vneshikj/Inductive-Drive-RC-Car/Implementation/Deliverables/EE734_IPT_Equation_Template_24_ldig874_vnes637.docx

IPT Pick-up Design Equations

Eq. # | Equation
(1) | Io (for R_L <11.66Ω ) is the largest current possible: I_(out) =1.1I_(sc) ≈1.29
(2) | Io (for R_L ≥11.66Ω ): I_(out) =(V_(out(nominal)))/(R_(Load))
(3) | Vout: V_(out) =I_(out) R_(Load)
(4) | Pout: P_(out) =(V_(out)^2)/(R_(Load))=I_(out)^2 R_(Load) =V_(out) I_(out)
(5) | Duty Cycle (D): P_(out) =P_(max) (1-D) D=1-(P_(out))/(P_(max)) Where Pmax is given by: P_(max) =(1.1I_(sc) ×V_(out(nominal)) )
(6) | Qmax: Q_(max) =(1.1 V_(out))/(V_(oc))
(7) | Qavg: Q_(avg) =(P_(out))/(S_u)=(V_(out) I_(out))/(V_(oc) I_(sc))
(8) | C2 Compensation Capacitor: Impedance matching to increase overall power: jωL_2 =-1/(jωC_2) Rearranging and solving, we are able to find C2: C_2 =|1/((jω)^2 L_2)
(9) | Max V2: We know that VC2 is the voltage before the rectifier stage and due to parallel compensation: V_(out, nominal) =(V_2)/1.1 Rearranging and solving we are able to find V2: V_2 =1.1⋅V_(out,nominal)
(10) | Max IC2: I_(c_2 ,max) =(V_2)/(Z_(C_2))=|j2πf_0 ⋅C_2 ⋅V_2
(11) | Cmin can be found with the following formula: C_(min) =C_(dc) >(πI_(sc))/(8√2f_(s,max) ΔV_(out))
(12) | fs (for R ≥ 11.66Ω ): f_s ≈(πI_(sc))/(8√2 C_(dc) ΔV_(out)) fs (for R < 11.66Ω, i.e. not sufficient to begin switching ): f_s =0
(13) | IC,rms: Given the two states of IC,rms when the switch is on and off: I_(C,RMS) =√(1/(T_s)∫_0^(DT_s) -I_(out)^2 dt+∫_(DT_s)^(T_s) (I_(dc) -I_(out) )^2)
(14) | Capacitor power loss ( P_(loss,C_(dc)) ): P_(loss,C_(dc)) =I_(rms,C_(dc))^2 ⋅R_(esr,C_(dc))
(15) | Evaluating feedback resistor network: 1. ΔV_(out) =V_(op) (R_a)/(R_f) 2. V_(out,avg) =V_(ref) (R_a R_b +R_f (R_a +R_b ))/(R_f R_b)-V_(op) (R_a)/(2R_f) Rearranging both equations for Rf and equating we get the following equation: V_(op) (R_a)/(ΔV_(out))=(-V_(op) R_a R_b +2V_(ref) R_a R_b)/(2V_(out,avg) R_b +2V_(ref) R_a ++2V_(ref) R_b) Subbing in chosen R_b =10kΩ and solving for Ra.
(16) | Rf can be found by using ‘1.’ from above solution: R_f =V_(op) (R_a)/(ΔV_(out))
(17) | N: L=A_L ⋅N_i^2 N=√(L/(A_L))
(18) | Bc(max): B_(c[max]) =(LI_(L,avg))/(NA_e)
(19) | Single strand copper cross sectional area (Acu): A_(cu) =(π d_(cu)^2)/4
(20) | Used winding area: K_f =(NA_(cu))/(A_N) ≤ 1 A_N =(NA_(cu))/(K_f)
(21) | Jmax: J_(max) =(I_(RMS(max)))/(A_(cu))
(22) | Bundle Rw (dc): R_(ω(dc)) =(ρNl_n)/(A_(cu))
(23) | Steady-state wire losses (Pcu): P_(cu) =R_(ω(dc)) ⋅I_(L,RMS)^2
(24) | Gate driver resistance (Rg): R_g =(V_(gg))/(I_(gg))
(25) | Is @ on: I_(s,on) =I_(L,avg) -(ΔI_L)/2 Is @ off: I_(s,on) =I_(L,avg) +(ΔI_L)/2 Where ΔI_L is given by: ΔI_L =(8 ΔV_(out) Cdc)/(T_s)
(26) | tvf: t_(vf) =(V_(sw) -R_(ds,ON) ⋅I_(s,ON) )(R_g C_(rss,V_(sw) /2))/(V_(gg) -V_(gs(io)))
(27) | tvr: t_(vr) =(V_(sw) -R_(ds,ON) ⋅I_(s,OFF) )(R_g C_(rss,V_(sw) /2))/(V_(gs(io)))
(28) | ts,on: t_(s,on) =t_(ir) +t_(vf) Where t_(ir) = current rise time and t_(vf) = voltage fall time.
(29) | ts,off: t_(s,off) =t_(if) +t_(vr) Where t_(if) = current fall time and t_(vr) = voltage rise time.
(30) | Pswitching: P_(switching) =(V_(s,off) f_s)/2[I_(s,on) t_(s,on) +I_(s,off) t_(s,off) ]
(31) | Pconduction: P_(conduction) =1/(T_s)∫_0^(T_(s,on)) V_s I_s dt=I_(s,RMS)^2 ⋅R_(ds,on)
(32) | Ptotal: P_(total) =P_(switching) +P_(conduction)
(33) | Tj,max: T_j =T_a +P_T R_(θja)
(34) | ID,avg: I_(D,avg) =(1-D)I_(D,avg[MAX])
(35) | Pconduction loss: P_(conduction) =(1-D)V_F I_(L,avg)
(36) | Reverse recovery loss (Prr): P_(rr) ≈V_R Q_(rr) f_s Where Q_(rr) =I_(rr) (t_(rr))/2 However, due to the Schottky diode’s physical make-up: P_(rr(schottky)) =0W
(37) | Ptotal: P_(total) =P_(conduction) +P_(rr)
(38) | Tj,max: Similar to (33): T_j =T_a +P_T R_(θja)
