vneshikj/Inductive-Drive-RC-Car/Implementation/Deliverables/EE734_IPT_Design_Report_24_ldig874_vnes637.xlsx

Sheet: Operating Conditions
Pick-up Converter Design - Part I
Specifications
Parameter | Value | Unit
Nominal Vout(avg) | 15.00 | V
Isc(rms) | 1.17 | A
Voc(rms) | 7.12 | V
Winding L2 | 25.00 | µH
Track f0 | 38.40 | kHz
Evaluating Steady-State Operating Conditions
Parameter | Value | Unit (eq) | Value | Unit (eq) | Value | Unit (eq)
Load | 10.00 | Ω | 15.00 | Ω | 25.00 | Ω
Io | 1.29 | A (1) | 1.00 | A (2) | 0.60 | A (2)
Vout | 12.87 | V (3) | 15.00 | V (3) | 15.00 | V (3)
Po | 16.56 | W (4) | 15.00 | W (4) | 9.00 | W (4)
D | 0.00 | % (5) | 22.30 | % (5) | 53.38 | % (5)
Qmax | 1.99 | (6) | 2.32 | (6) | 2.32 | (6)
Qavg | 1.99 | (7) | 1.80 | (7) | 1.08 | (7)
Evaluating Compensation Capacitor
Parameter | Value | Unit (eq)
C2 | 0.67 | µF (8)
Max V2 | 16.50 | V (9)
Max IC2 | 2.67 | A (10)

Sheet: Capacitor & Controller
Pick-up Converter Design - Part II
Specifications
Parameter | Value | Unit
Max fs | 1000.00 | Hz
Nominal Vout | 15.00 | V
Max Iout | 1.29 | A
Design ΔVo | 1.00 | V,peak to peak
Minimum Capacitance to Meet ΔVo
Parameter | Value | Unit (eq)
C(min) | 324.89 | µF (11)
Selecting a Capacitor
Parameter | Value | Unit
Manufacturer | Panasonic
Series | TP
Voltage rating | 25 | V
Capacitance | 470 | µF
ESR | 130 | mΩ
IC,rms rating | 1.1 | A
Evaluating Steady-State Capacitor Losses
Parameter | Value | Unit (eq) | Value | Unit (eq) | Value | Unit (eq)
Load | 10.0 | Ω | 15.0 | Ω | 25.0 | Ω
fs | 0.0 | Hz (12) | 479.1 | Hz (12) | 688.1 | Hz (12)
IC,rms | 0.0 | A (13) | 0.5 | A (13) | 0.6 | A (13)
PC | 0.0 | mW (14) | 37.3 | mW (14) | 53.8 | mW (14)
Evaluating Feedback Resistor Network
Parameter | Value | Unit
Vref | 4.00 | V | E12 Series Values used in slides
Vo,opamp | 15.00 | V
Selected Rb | 10.00 | kΩ
Ra | 14.33 | kΩ (15)
Rf | 214.95 | kΩ (16)

Sheet: Inductor
Pick-up Converter Design - Part III
Specifications
Parameter | Value | Unit
Max IL(Avg) | 1.29 | A
Ripple fs | 38.40 | kHz
Design Bmax | 0.25 | T
Design Jmax | 5.00 | A/mm^2
Core & Magnet Wire Details
Parameter | Value | Unit
Core type | Drum15
Al | 0.052 | µH
Ae | 28.30 | mm^2
AN | 36.00 | mm^2
ln | 31.50 | mm
Wire ρ | 1.8e-08 | Ωm
Wire µ0 | 1.256637061e-06 | H/m
Achievable Kf | 0.70
Design Choices
Parameter | Value | Unit (eq)
Selected L | 200.00 | µH
Selected dcu | 0.56 | mm
Evaluating Inductor Parameters
Parameter | Value | Unit (eq)
N | 63 | Turns (17)
Bc(max) | 0.14 | T (18)
Acu (1 strand) | 0.2463 | mm^2 (19)
Used Winding Area | 22.17 | mm^2 (20)
Jmax | 5.24 | A/mm^2 (21)
Bundle Rw(dc) | 145.0 | mΩ (22)
Evaluating Steady-State Inductor Losses
Parameter | Value | Unit (eq) | Value | Unit (eq) | Value | Unit (eq)
Load | 10.0 | Ω | 15.0 | Ω | 25.0 | Ω
IL,rms | 1.3 | A | 1.3 | A | 1.3 | A
Pcu | 241.34 | mW (23) | 241.34 | mW (23) | 241.34 | mW (23)

Sheet: Switch
Pick-up Conveter Design - Part IV
Specifications
Parameter | Value | Unit
Max Vsw | 15.00 | V
Max Is,rms | 1.29 | A
Ta | 30.00 | Degrees C
Selecting a N-Channel MOSFET
Parameter | Value | Unit
Manufacturer | infineon
Model no | IPP052N06L3
Vdss | 60 | V
ID(max) | 80 | A
tr | 5 | ns
tf | 12 | ns
Crss @ Max Vsw/2 | 47 | pF
Vgs(Io) | 4.5 | V
Rds,on | 5 | mΩ
RthJA - no heatsink | 62 | C/W
Gate Drive Details
Parameter | Value | Unit (eq)
Design Vgg | 15.00 | V
Design Igg | 0.10 | A
Rg | 150.00 | Ω (24)
Evaluating Steady-State Switch Losses
Parameter | Value | Unit (eq) | Value | Unit (eq) | Value | Unit (eq)
Load | 10.00 | Ω | 15.0 | Ω | 25.0 | Ω
fs | 0.00 | Hz | 479.09 | Hz | 688.09 | Hz
Is,rms | 0.00 | A | 0.61 | A | 0.94 | A
Is @ on | 0.00 | A (25) | 0.66 | A (25) | 0.39 | A (25)
Is @ off | 0.00 | A (25) | 1.91 | A (25) | 2.18 | A (25)
tfv | 10.07 | ns (26) | 10.07 | ns (26) | 10.07 | ns (26)
trv | 23.49 | ns (27) | 23.49 | ns (27) | 23.49 | ns (27)
ts,on | 15.07 | ns (28) | 15.07 | ns (28) | 15.07 | ns (28)
ts,off | 35.49 | ns (29) | 35.49 | ns (29) | 35.49 | ns (29)
Pswitching | 0.00 | mW (30) | 0.28 | mW (30) | 0.43 | mW (30)
Pconduction | 0.00 | mw (31) | 1.85 | mw (31) | 4.42 | mw (31)
Ptotal | 0.00 | mw (32) | 2.13 | mw (32) | 4.85 | mw (32)
Evaluating Junction Temperature
Parameter | Value | Unit (eq)
Tj,max | 30.30 | C (33)

Sheet: Diode
Pick-up Converter Design - Part V
Specifications
Parameter | Value | Unit (eq)
Max Vd | 15.00 | V
Max Id,avg | 1.29 | A
Ta | 30.00 | Degrees C
Selecting a Diode
Parameter | Value | Unit
Manufacturer | Vishay
Model no | VS-MBR1045-M3
Vr(max) | 45 | V
IF(max) - dual | 10 | A
VF | 0.57 | V
RthJA - D2Pak | n/a | C/W
Evaluating Steady-State Switch Losses
Parameter | Value | Unit (eq) | Value | Unit (eq) | Value | Unit (eq)
Load | 10.00 | Ω | 15.0 | Ω | 25.0 | Ω
D | 0.00 | % | 22.30 | % | 53.38 | %
ID,avg | 1.29 | A (34) | 1.00 | A (34) | 0.60 | A (34)
Pconduction | 0.73 | W (35) | 0.57 | W (35) | 0.34 | W (35)
Prr | 0.00 | W (36) | 0.00 | W (36) | 0.00 | W (36)
Ptotal | 0.73 | W (37) | 0.57 | W (37) | 0.34 | W (37)
Evaluating Junction Temperature
Parameter | Value | Unit (eq)
Tj,max | 75.00 | C (38) | Approximation assuming similar RthJA to MOSFET
