vneshikj/Inductive-Drive-RC-Car/Implementation/Buck/EE734_Buck_Design_Template_24_UPI.xlsx

Sheet: Operating Conditions
Buck Conveter Design - Part I
Specifications
Parameter | Value | Unit
Nominal Vin(avg) | 15.00 | V
Max Iin(avg) | 1.30 | A
Max Vout(avg) | 9.70 | V
Max RL(max) | 10.00 | Ω
Min RL(min) | 2.00 | Ω
Design η | 90.00 | %
Operating fs | 100.00 | kHz
Evaluating Steady-State Operating Conditions
Parameter | Value | Unit (eq) | Value | Unit (eq) | Value | Unit (eq)
Load RL | 2.00 | Ω | 4.00 | Ω | 10.00 | Ω
Pout | 17.55 | W (1) | 17.55 | W (1) | 9.41 | W (2)
Io=IL(avg) | 2.96 | A (3) | 2.10 | A (3) | 1.32 | A (3)
Iin(avg)=Is(avg) | 1.30 | A (4) | 1.30 | A (4) | 0.70 | A (4)
D | 43.88 | % (5) | 62.07 | % (5) | 71.85 | % (5)
Vout | 5.92 | V (6) | 8.38 | V (6) | 9.70 | V (6)
Evaluating Minimum Inductance
Parameter | Value | Unit (eq)
Vin(critical) | 15.00 | V
RL(critical) | 10.00 | Ω
D @ RL(critical) | 71.85 | %
Lmin | 10.27 | µH (7)
Selected Inductance
Parameter | Value | Unit (eq)
L(selected) | 25.00 | µH
Evaluating Steady-State Ripple and RMS Curents
Parameter | Value | Unit (eq) | Value | Unit (eq) | Value | Unit (eq)
Load RL | 2.00 | Ω | 4.00 | Ω | 10.00 | Ω
ΔIL | 1.33 | A (8) | 1.27 | A (8) | 1.09 | A (8)
IL,pk | 3.63 | A (9) | 2.74 | A (9) | 1.88 | A (9)
IL,rms | 2.98 | A (10) | 2.13 | A (10) | 1.37 | A (10)
Iin,rms=Is,rms | 1.98 | A (11) | 1.68 | A (11) | 1.16 | A (11)
IC,rms | 0.38 | A (12) | 0.37 | A (12) | 0.31 | A (12)

Sheet: Inductor
Buck Conveter Design - Part II
Specifications
Parameter | Value | Unit
Selected L | 25.00 | µH
Max IL,pk | 3.63 | A
Max IL,rms | 2.98 | A
Operating fs | 100.00 | kHz
Design Bmax | 0.25 | T
Design Jmax | 5.00 | A/mm^2
Core, Former & Magnet Wire Details
Parameter | Value | Unit
Core type | EFD20
Core material | N87
Ae | 31.00 | mm^2
le | 47.00 | mm
Ve | 1460.00 | mm^3
AN | 28.10 | mm^2
ln | 40.20 | mm
Wire ρ | 1.8e-08 | Ωm
Wire µ0 | 1.256637061e-06 | H/m
Achievable Kf | 0.65
Design Choices
Parameter | Value | Unit (eq)
Selected Air-gap (lg) | 0.15 | mm
Wire dcu | 0.43 | mm (13)
Evaluating Inductor Parameters
Parameter | Value | Unit (eq)
N | 14 (13.64) | Turns (14)
Bc(max) | 0.22 | T (15)
Acu per strand | 1.45e-07 | m^2 (16)
Np | 9 | Strands (17)
Acu per bundle | 1.31e-06 | m^2 (18)
Jmax | 2.27 | A/mm^2 (19)
Bundle Rw(dc) | 7.7 | mΩ (20)
Evaluating Steady-State Inductor Losses
Parameter | Value | Unit (eq) | Value | Unit (eq) | Value | Unit (eq)
Load RL | 2.0 | Ω | 4.0 | Ω | 10.0 | Ω
IL,rms | 2.98 | A | 2.13 | A | 1.37 | A
ΔIL | 1.33 | A | 1.27 | A | 1.09 | A
Bac | 40.30 | mT (21) | 38.48 | mT (21) | 33.03 | mT (21)
Pcu | 68.67 | mW (22) | 35.08 | mW (22) | 14.51 | mW (22)
Pv | 8.99 | mW (23) | 8.01 | mW (23) | 5.47 | mW (23)
Ptotal | 77.66 | mW (24) | 43.09 | mW (24) | 19.98 | mW (24)

Sheet: Capacitor
Buck Conveter Design - Part III
Specifications
Parameter | Value | Unit
Max Vc | 9.70 | V
Max IC,rms | 0.38 | A
Max ΔIC=ΔIL | 1.33 | A
Ripple fs | 100.00 | kHz
Design ΔVo | 1.00 | %
Minimum Capacitance to Meet ΔVo
Parameter | Value | Unit (eq)
Co(min) | 17.14 | µF (25)
ESR(max) | 72.93 | mΩ (26)
Selecting a Capacitor
Parameter | Value | Unit
Manufacturer | Panasonic
Series | TP
Voltage rating | 35 | V
Capacitance Co | 330 | µF
ESR | 52 | mΩ
IC,rms rating | 1.1 | A
Evaluating Steady-State Capacitor Losses
Parameter | Value | Unit (eq) | Value | Unit (eq) | Value | Unit (eq)
Load RL | 2.0 | Ω | 4.0 | Ω | 10.0 | Ω
IC,rms | 0.38 | A | 0.37 | A | 0.31 | A
PC | 7.5 | mW (27) | 7.1 | mW (27) | 5.0 | mW (27)

Sheet: Switch
Buck Conveter Design - Part IV
Specifications
Parameter | Value | Unit
Max Vsw | 15.00 | V
Max Is,rms | 1.98 | A
Max Isw,pk | 3.63 | A
Switching fs | 100.00 | kHz
Ta | 30.00 | Degrees C
Selecting a N-Channel MOSFET
Parameter | Value | Unit
Manufacturer | Infineon
Model no | IPP052N06L3
Vdss | 60 | V
ID(max) | 80 | A
tr | 5 | ns
tf | 12 | ns
Crss @ Max Vsw/2 | 175 | pF
Vgs(Io) | 3.6 | V
Rds,on | 3.9 | mΩ
RthJA - no heatsink | 62 | C/W
Gate Drive Details
Parameter | Value | Unit (eq)
Design Vgg | 15.00 | V
Design Igg | 1.00 | A
Rg | 15.00 | Ω (28)
Evaluating Steady-State Switch Losses
Parameter | Value | Unit (eq) | Value | Unit (eq) | Value | Unit (eq)
Load RL | 2.00 | Ω | 4.0 | Ω | 10.0 | Ω
IL,avg | 2.96 | A | 2.10 | A | 1.32 | A
Is,rms | 1.98 | A | 1.68 | A | 1.16 | A
ΔIL | 1.33 | A | 1.27 | A | 1.09 | A
Is @ on | 2.30 | A (29) | 1.47 | A (29) | 0.79 | A (29)
Is @ off | 3.63 | A (30) | 2.74 | A (30) | 1.88 | A (30)
tvf | 3.45 | ns (31) | 3.45 | ns (31) | 3.45 | ns (31)
trv | 10.93 | ns (32) | 10.93 | ns (32) | 10.93 | ns (32)
ts,on | 8.45 | ns (33) | 8.45 | ns (33) | 8.45 | ns (33)
ts,off | 22.93 | ns (34) | 22.93 | ns (34) | 22.93 | ns (34)
Pswitching | 77.00 | mW (35) | 56.44 | mW (35) | 37.34 | mW (35)
Pconduction | 15.30 | mW (36) | 11.01 | mW (36) | 5.25 | mW (36)
Ptotal | 92.30 | mw (37) | 67.45 | mw (37) | 42.59 | mw (37)
Evaluating Junction Temprature
Parameter | Value | Unit (eq)
Tj,max | 35.72 | C (38)

Sheet: Diode
Buck Conveter Design - Part V
Specifications
Parameter | Value | Unit (eq)
Max Vd | 15.00 | V
Max Id,avg | 1.66 | A
Switching fs | 100.00 | kHz
Ta | 30.00 | Degrees C
Selecting a Diode
Parameter | Value | Unit
Manufacturer | Vishay
Model no | VS-MBR1045-M3
Vr(max) | 45 | V
IF(max) - dual | 10 | A
VF | 0.57 | V
RthJA - D2Pak | 70 | C/W | Assuming same thermal resistance as the other diodes with same case
Evaluating Steady-State Switch Losses
Parameter | Value | Unit (eq) | Value | Unit (eq) | Value | Unit (eq)
Load RL | 2.00 | Ω | 4.0 | Ω | 10.0 | Ω
IL,avg | 2.96 | A | 2.10 | A | 1.32 | A
D | 43.88 | % | 62.07 | % | 71.85 | %
ID,avg | 1.66 | A (39) | 0.80 | A (39) | 0.37 | A (39)
Pconduction | 0.94 | W (40) | 0.46 | W (40) | 0.21 | W (40)
Prr | 0.00 | W (41) | 0.00 | W (41) | 0.00 | W (41)
Ptotal | 0.94 | W (42) | 0.94 | W (42) | 0.94 | W (42)
Evaluating Junction Temprature
Parameter | Value | Unit (eq)
Tj,max | 95.80 | C (43)

Sheet: Controller
Buck Converter Design - Part VI
Specifications
Parameter | Value | Unit
Vout,nominal | 9.70 | V
Max Is,pk | 3.63 | A
Co | 330.00 | µF
ESR | 52 | mΩ
Switching fs | 100.00 | kHz
Max Td | 5.00 | %
Oscilator Setup
Parameter | Value | Unit (eq)
CT | 1 | nF
RT | 18k | kΩ
Td | 320 | ns
Current Feedback Setup
Parameter | Value | Unit (eq)
Rs | 0.28 | Ω (44)
RC filter - Rrc | 100.00 | Ω
RC filter - Crc | 159.15 | pF (45)
Voltage Feedback Setup
Parameter | Value | Unit (eq)
Tp(s) Pole fo @ 2Ω | 241.14 | Hz (46)
Tp(s) Zero fz @ 2Ω | 9.27 | kHz (47)
Tp(0) @ 2Ω | 17.71 | dB (48)
Design TOL(s) fcross | 10.00 | kHz
Tm(s) | 1.00
Required TOL(0) @ 2Ω | 32.35 | dB (49)
Required Tc(0) | 14.63 | dB (50)
Compensator Rf | 22.00 | kΩ
Compensator Cf | 0.78 | nF (51)
Compensator Ri | 4.08 | kΩ (52)
Diff Amp Gain Gdiff | 0.26 | Gain (53)
Schematic of Controller
