vneshikj/Inductive-Drive-RC-Car/Implementation/Buck/EE734_Buck_Equations_Template_24_UPI.docx

Buck Converter Design Equations

Eq. # | Equation
(1) | I_(OUT(MAX)) =√((V_(IN) I_(IN) η)/(R_(LOAD))) V_(OUT) =I×R_(LOAD) P_(OUT) =(V_(OUT) ^2)/(R_(LOAD))
(2) | P_(OUT) =(V_(OUT(MAX)) ^2)/(R_(LOAD))
(3) | I_(OUT) =(V_(OUT))/(R_(LOAD))
(4) | D=(V_(OUT))/(V_(IN) ×η) R_(IN) =1/(D^2)×R_(OUT) I_(IN) =(V_(IN))/(R_(IN))
(5) | D=(V_(OUT))/(V_(IN) ×η)
(6) | V_(OUT) =I_(OUT) ×R_(OUT) ( I_(OUT) is limited by I_(OUT(MAX)) OR V_(OUT(MAX)) )
(7) | L_(min) =(V_(OUT(MAX)) (1-D)T_S)/(ΔI_L) Where: ΔI_L =2I_(L(AVG))
(8) | ΔI_L =(V_(OUT) (1-D)T_S)/L
(9) | I_(L(peak)) =1/2ΔI_L ×I_(L(AVG))
(10) | I_(L(RMS)) =√(I_(L(AVG)) +(ΔI_L^2)/12)
(11) | I_(S(RMS)) =√([D[I_(L(AVG))^2 +(ΔI_L^2)/12]])
(12) | I_(C(RMS)) =(ΔI_L)/(√((12)))
(13) | d_(cu) ≤2δ δ=√(ρ/(πμ_0 μ_r f))
(14) | N=√((2l_g L)/(A_e μ_0))
(15) | B_(C(MAX)) =(Nμ_0 I_(MAX))/(2l_g)
(16) | A_(CU(STRAND)) =π(d_(cu)^2)/4
(17) | N_(CU) =(K_f ⋅A_N)/(N⋅A_(CU))
(18) | A_(CU(BUNDLE)) =N_P ×A_(CU(STRAND))
(19) | J_(MAX) =(I_(RMS(MAX)))/(A_(CU(STRAND)) ×10^6) (In A mm^(-2) )
(20) | R_(W(BUNDLE, DC)) =(ρ⋅N⋅I_n)/(A_(CU(BUNDLE)))
(21) | B_(ac) =(B_(MAX))/(I_(L(MAX)))×(ΔI_L)/2
(22) | R_(w(DC)) =(ρNI_n)/(A_(CU(BUNDLE))) P_(CU) =R_(w(DC)) ×I_(L(RMS))^2
(23) | P_V =k⋅f^a ⋅B_(ac) ^b Where: k=1.5⋅10^(-6) a = 1.3 b = 2.5 P_(LOSS(AC)) =P_V ×V_e Results given in mW
(24) | P_(TOTAL) =P_(cu) +P_(LOSS(AC))
(25) | C_(O(MIN)) ≥(ΔI_L T_s)/(8ΔV_o)
(26) | R_(ESR(MAX)) =(ΔV_o)/(ΔI_L)
(27) | P_C =I_(C(RMS))^2 ×R_(ESR)
(28) | R_g =(V_(gg))/(I_(gg))
(29) | I_(S(ON)) =I_(L(AVG)) -(ΔI_L)/2
(30) | I_(S(OFF)) =I_(L(AVG)) +(ΔI_L)/2
(31) | t_(fv) =(V_(ds(OFF)) -R_(DS(ON)) I_(S(ON)) )×(R_g C_(rss(Vsoff/2)))/(V_(gg) -V_(gs(I_o )))
(32) | t_(rv) =(V_(ds(OFF)) -R_(DS(ON)) I_(S(OFF)) )×(R_g C_(rss(Vsoff/2)))/(V_(gs(I_o )))
(33) | T_(S(ON)) =t_r +t_(fv)
(34) | T_(S(OFF)) =t_f +t_(rv)
(35) | P_(SWITCHING) =(V_(S(OFF)) f_s)/2×[I_(S(ON)) t_(S(ON)) +I_(S(OFF)) t_(S(OFF)) ]
(36) | P_(CONDUCTION) =I_(S(RMS))^2 ×R_(DS(ON))
(37) | P_(TOTAL) =P_(CONDUCTION) +P_(SWITCHING)
(38) | T_(j(MAX)) =T_a +P_T ×R_(θja)
(39) | I_(D(AVG)) =I_(L(AVG)) (1-D)
(40) | P_(CONDUCTION) =I_(D(AVG)) ⋅V_F
(41) | P_(rr) =V_R Q_(rr) f_s
(42) | P_(TOTAL) =P_(CONDUCTION) +P_(SWITCHING)
(43) | T_(j(MAX)) =T_a +P_T ×R_(θja)
(44) | R_S =1/(I_(S(MAX)))
(45) | C_(rc) =1/(2πR_c f_(cutoff))
(46) | T_p (s)=(R_L)/(R_S)×(sC_(out) r_(esr) +1)/(sC_(out) R_L +1)
(47) | f_p =1/(2πC_o R_L)
(48) | f_z =1/(2πC_o R_c)
(49) | T_c (0)=log[(f_(cross))/(f_p)]×20 –T_p (0) T_p (0)=(R_L)/(R_s) T_(OL) (0)=T_p (0)⋅T_c (0)⋅T_m (0)
(50) | T_c (0)=log[(f_(cross))/(f_p)]×20 –T_p (0)
(51) | C_f =1/(2πf_p R_f) Where: f_p is set to cancel plant zero
(52) | R_i =(R_f)/(10^((T_c (0))/20)) Where: T_c (0) is gain in dB
(53) | G_(DIFF) =2.5/(V_(OUT(NOMINAL)))
