vneshikj/Inductive-Drive-RC-Car/Labs/Lab 1/Lab workings.docx

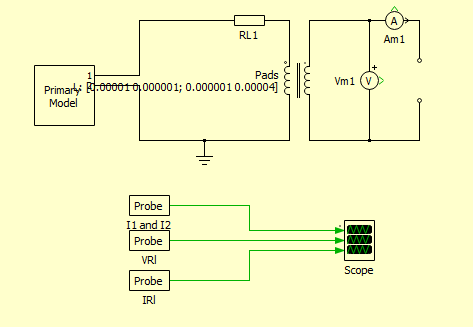
[picture p2: figure]
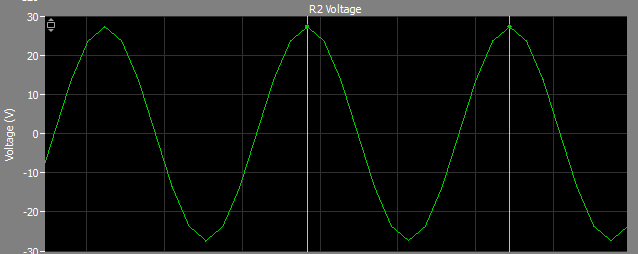
[picture p3: figure]
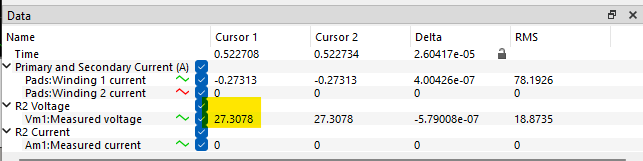
[picture p4: figure]
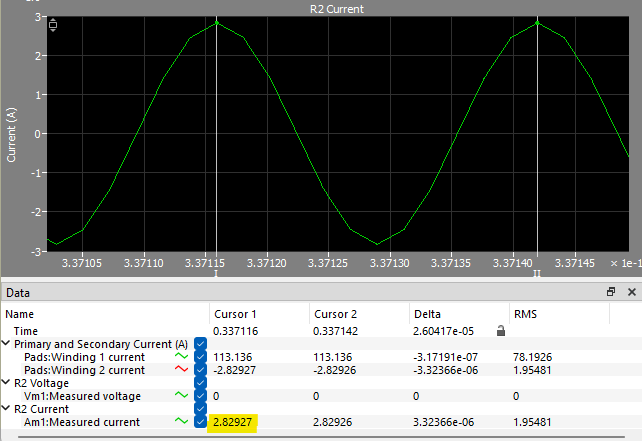
[picture p5: figure]

Task 2

Used the following values

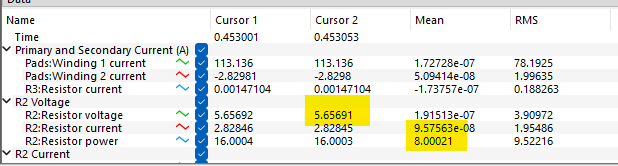
[picture p6: figure]

2ohms

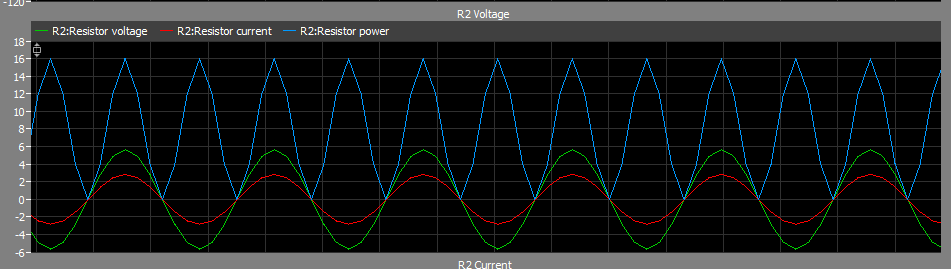
[picture p7: figure]

4ohms

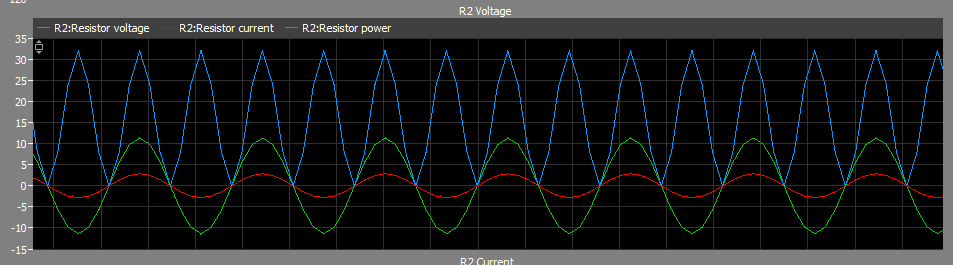
[picture p8: figure]

8ohms

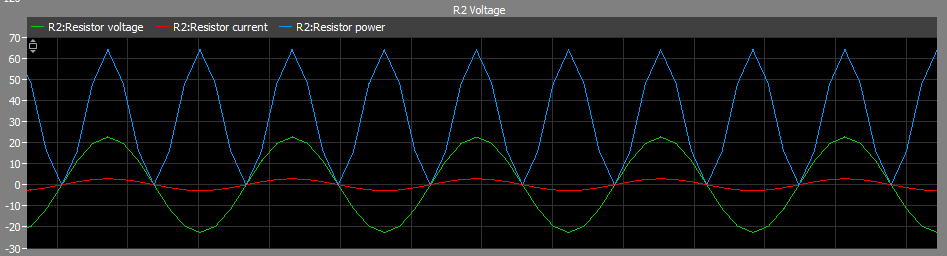
[picture p9: figure]

12ohms

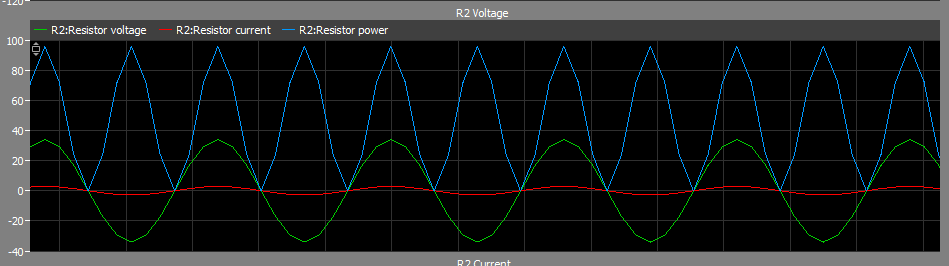
[picture p10: figure]

16ohms

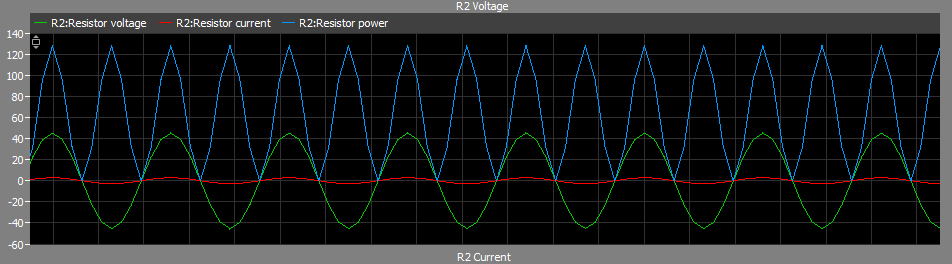
[picture p11: figure]

Task 3

b)

R = 2

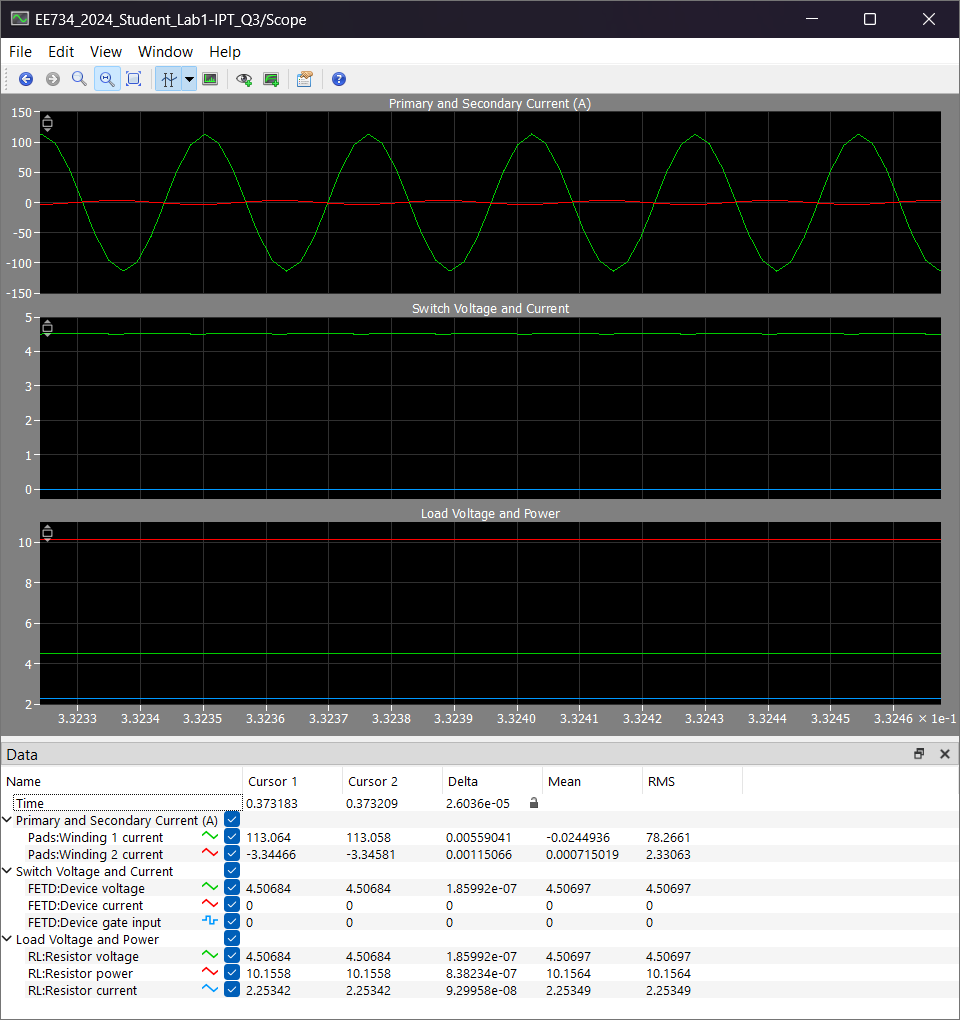
[picture p12: figure]

R = 4

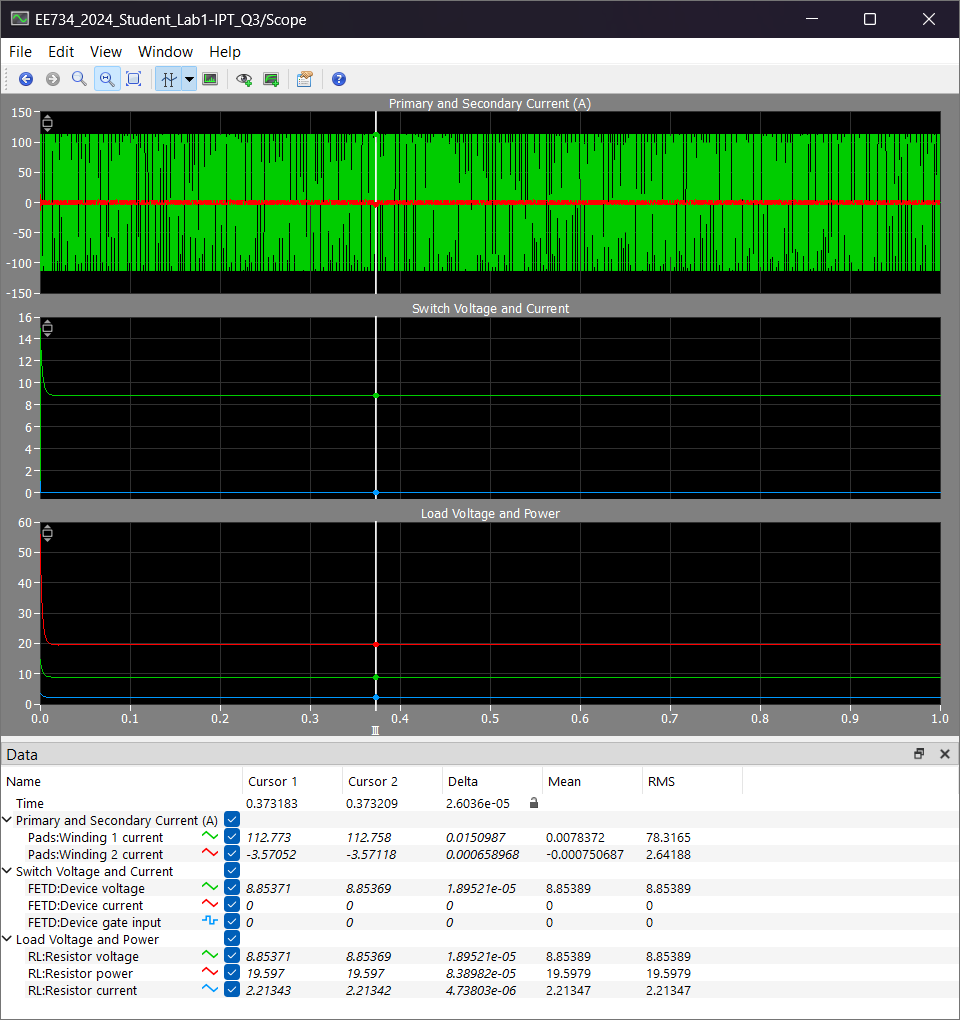
[picture p13: figure]

R=8

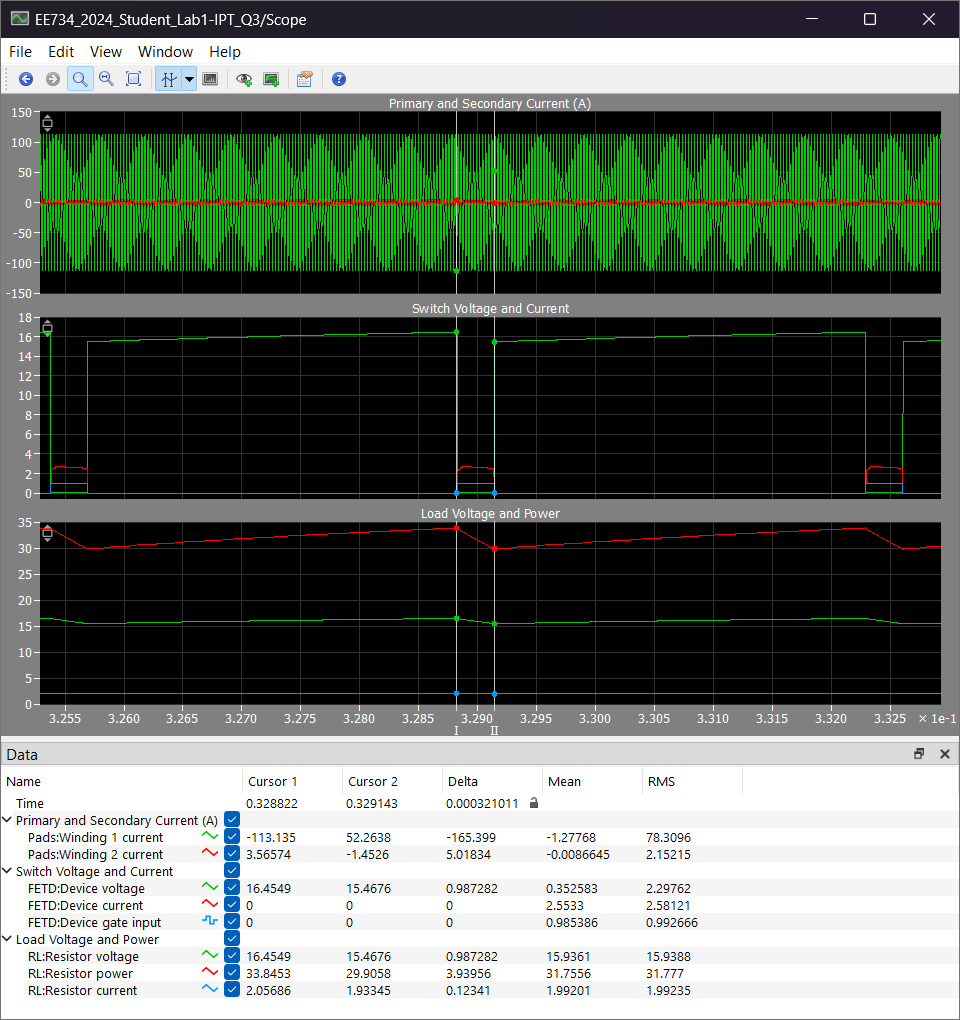
[picture p14: figure]

R = 12

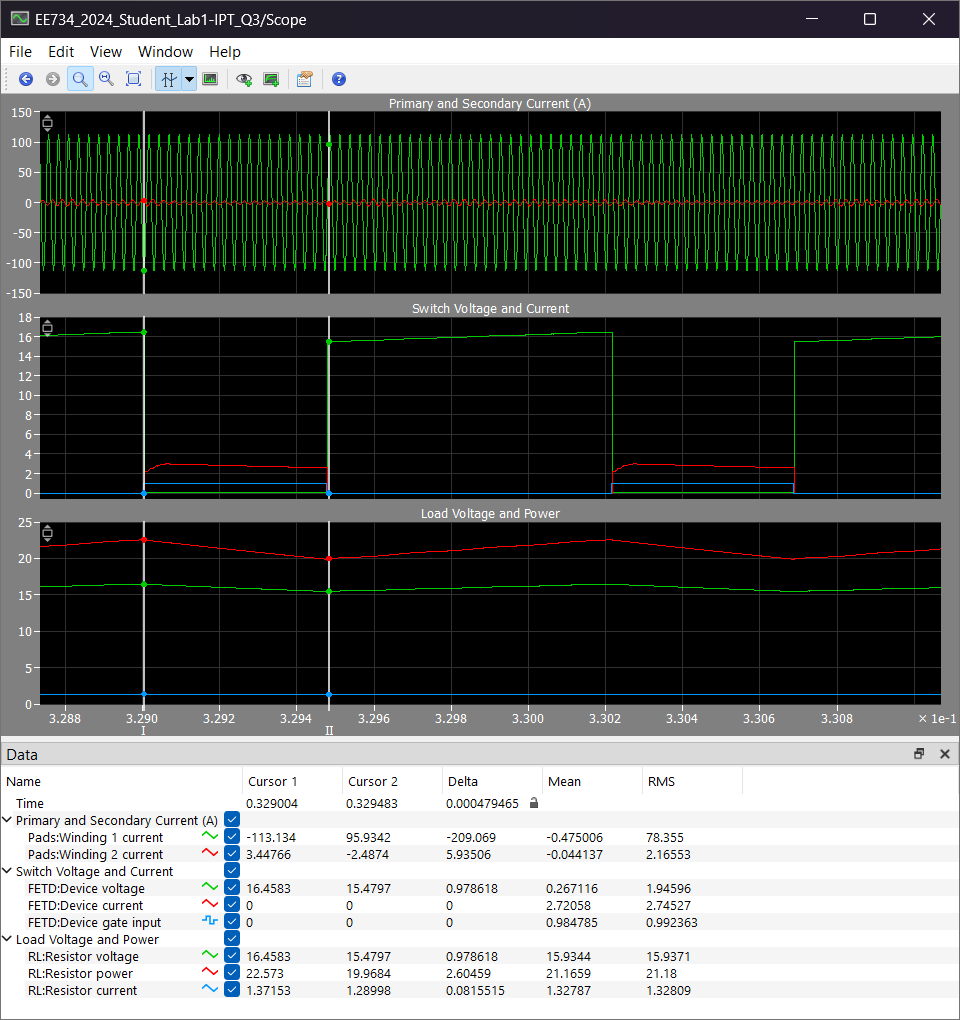
[picture p15: figure]

R = 16

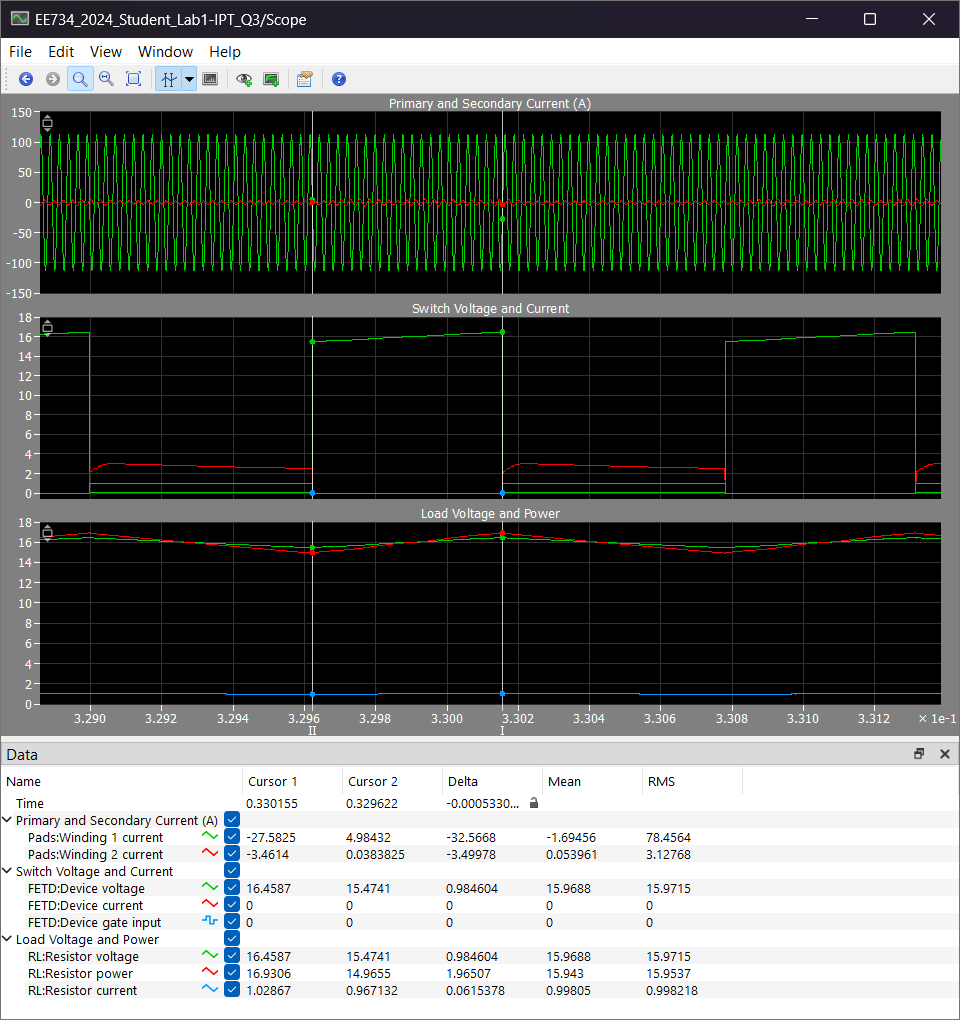
[picture p16: figure]

c)
