vneshikj/Inductive-Drive-RC-Car/Implementation/Component List 2024.xlsx

Select the most suitable component for your design
Options Available for Pickup Diode
1 | 1N4148 (https://www.vishay.com/docs/81857/1n4148.pdf)
2 | VS-MBR1045-M3 (https://www.vishay.com/docs/96266/vs-mbr1035-m3.pdf)
3 | VS-15ETH06-M3 (https://www.vishay.com/docs/96174/vs-15eth06.pdf)
Options Available for Pickup MOSFET
1 | IPA90R1K2C3 (https://www.infineon.com/dgdl/IPA90R1K2C3_1.0.pdf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)
2 | IPP052N06L3 (https://www.infineon.com/dgdl/Infineon-IPP_B052N06L3-DS-v02_04-en.pdf?fileId=db3a30432313ff5e0123a32d97c125b6)
3 | IRF9Z14PBF (https://www.vishay.com/docs/91088/91088.pdf)
Options Available for Buck Diode
1 | 1N4148 (https://www.vishay.com/docs/81857/1n4148.pdf)
2 | VS-MBR1045-M3 (https://www.vishay.com/docs/96266/vs-mbr1035-m3.pdf)
3 | VS-15ETH06-M3 (https://www.vishay.com/docs/96174/vs-15eth06.pdf)
Options Available for Buck MOSFET
1 | IPA90R1K2C3 (https://www.infineon.com/dgdl/IPA90R1K2C3_1.0.pdf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)
2 | IPP052N06L3 (https://www.infineon.com/dgdl/Infineon-IPP_B052N06L3-DS-v02_04-en.pdf?fileId=db3a30432313ff5e0123a32d97c125b6)
3 | IRF9Z14PBF (https://www.vishay.com/docs/91088/91088.pdf)
