vneshikj/Inductive-Drive-RC-Car/(list of files, drawings)

Other design files:
Implementation/Altium/Buck_2009/currentmode_buck.PCBDOC
Implementation/Altium/Buck_2009/currentmode_buck.PCBLIB
Implementation/Altium/Buck_2009/currentmode_buck.PrjPcb
Implementation/Altium/Buck_2009/currentmode_buck.SCHDOC
Implementation/Altium/regulator pcb_2009/regulator.PCB
Implementation/Altium/regulator pcb_2009/regulator.PCBDOC
Implementation/Altium/regulator pcb_2009/regulator.PCBLIB
Implementation/Altium/regulator pcb_2009/regulator.PrjPcb
Implementation/Deliverables/currentmode_buck_vnes637_ldig874.SCHDOC
