vneshikj/Inductive-Drive-RC-Car/(commit log)

2024-03-11 feat(Labs): :sparkles: Added Excel sheet with graph showing sim vs. theo results.
    [Task3C.xlsx]
2024-03-17 feat(labs): :sparkles: Added excel file for task 1
    [Lab 2.xlsx]
2024-03-18 feat(labs): :sparkles: Saving work from excel sheet from labs
    [Lab 2.xlsx]
2024-03-19 excel for lab 2
    [Lab 2.xlsx]
2024-03-20 feat(labs): :sparkles: Updated excels sheets
    [Lab 2.xlsx]
2024-03-26 feat(labs): :sparkles: Added excel files for lab 2
    [Lab 2.xlsx]
2024-03-27 feat(labs): :sparkles: Finished lab2, added matlab simulation files for task 4 and final excel spreadsheet
    [Lab 2.xlsx]
2024-04-22 feat(Implementation): Added project files.
    [Component List 2024.xlsx, EE734_Buck_Design_Template_24_UPI.xlsx, EE734_IPT_Design_Report_24_UPI.xlsx, currentmode_buck.PCBDOC, currentmode_buck.PCBLIB, currentmode_buck.PrjPcb, currentmode_buck.SCHDOC, regulator.PCB]
2024-04-22 feat(IPT): Calculations for the first block completed.
    [EE734_IPT_Design_Report_24_UPI.xlsx]
2024-04-22 feat(IPT): Partial completion of compensator values
    [EE734_IPT_Design_Report_24_UPI.xlsx]
2024-04-22 feat(buck design): :sparkles: Completed first block
    - Need to check if Vin is limited by Buck input impedance
    [EE734_Buck_Design_Template_24_UPI.xlsx]
2024-04-23 feat(IPT): Partial completion of Cdc calculations.
    [EE734_IPT_Design_Report_24_UPI.xlsx]
2024-04-24 feat(IPT): Pick-up converter design part II - Capacitor and controller calculations.
    [EE734_IPT_Design_Report_24_UPI.xlsx]
2024-04-24 feat(buck design): :sparkles: Saving work
    [EE734_Buck_Design_Template_24_UPI.xlsx]
2024-04-30 feat(buck-design): :sparkles: Finished operating conditions sheet
    [EE734_Buck_Design_Template_24_UPI.xlsx]
2024-04-30 feat(buck-design): :sparkles: Added equations for buck
    [EE734_Buck_Design_Template_24_UPI.xlsx]
2024-05-01 feat(buck-design): :sparkles: Finished inductor design, missing losses
    [EE734_Buck_Design_Template_24_UPI.xlsx]
2024-05-01 feat(IPT): Added datasheets for MOSFET and diode.
2024-05-01 feat(buck-design): :sparkles: Finished capacitor sheet, inductor sheet, halfway done with switch sheet. Equations updated up to capacitor
    [EE734_Buck_Design_Template_24_UPI.xlsx]
2024-05-01 feat(IPT): Partial completion of FET and diode calculations.
    [EE734_IPT_Design_Report_24_UPI.xlsx]
2024-05-02 feat(buck-design): :sparkles: Almost completed switch sheet, equation not updated
    [EE734_Buck_Design_Template_24_UPI.xlsx]
2024-05-02 feat(buck-design): :sparkles: Progress made with buck design
    [EE734_Buck_Design_Template_24_UPI.xlsx, currentmode_buck.SCHDOC]
2024-05-02 feat(IPT): Completed all calculations for IPT implementation. TO DO: Populate remaining equations.
    [EE734_IPT_Design_Report_24_UPI.xlsx]
2024-05-03 feat(IPT): Completed IPT section.
    [EE734_IPT_Design_Report_24_UPI.xlsx, EE734_IPT_Design_Report_24_ldig874_vnes637.xlsx]
2024-05-03 feat(buck): :sparkles: Almost done with altium
    [EE734_Buck_Design_Template_24_UPI.xlsx, currentmode_buck.SCHDOC]
2024-05-03 feat(buck + IPT): :sparkles: Completed design
    [EE734_Buck_Design_Template_24_UPI.xlsx, currentmode_buck.SCHDOC, regulator.SCH]
2024-05-03 chore(submission): :truck: Gathering files
    [EE734_Buck_Design_Template_24_vnes637_ldig874.xlsx, EE734_IPT_Design_Report_24_ldig874_vnes637.xlsx, currentmode_buck_vnes637_ldig874.SCHDOC, regulator_vnes637_ldig_874.SCH]
2024-05-28 feat: :sparkles: Reorganising file structure
    [Component List 2024.xlsx, EE734_Buck_Design_Template_24_UPI.xlsx, EE734_Buck_Design_Template_24_vnes637_ldig874.xlsx, EE734_IPT_Design_Report_24_UPI.xlsx, EE734_IPT_Design_Report_24_ldig874_vnes637.xlsx, currentmode_buck.PCBDOC, currentmode_buck.PCBLIB, currentmode_buck.PrjPcb]
